maximus64/pigeki/RP2040_minimal.kicad_pcb

## KiCad design RP2040_minimal.kicad_pcb (2023-03-06)

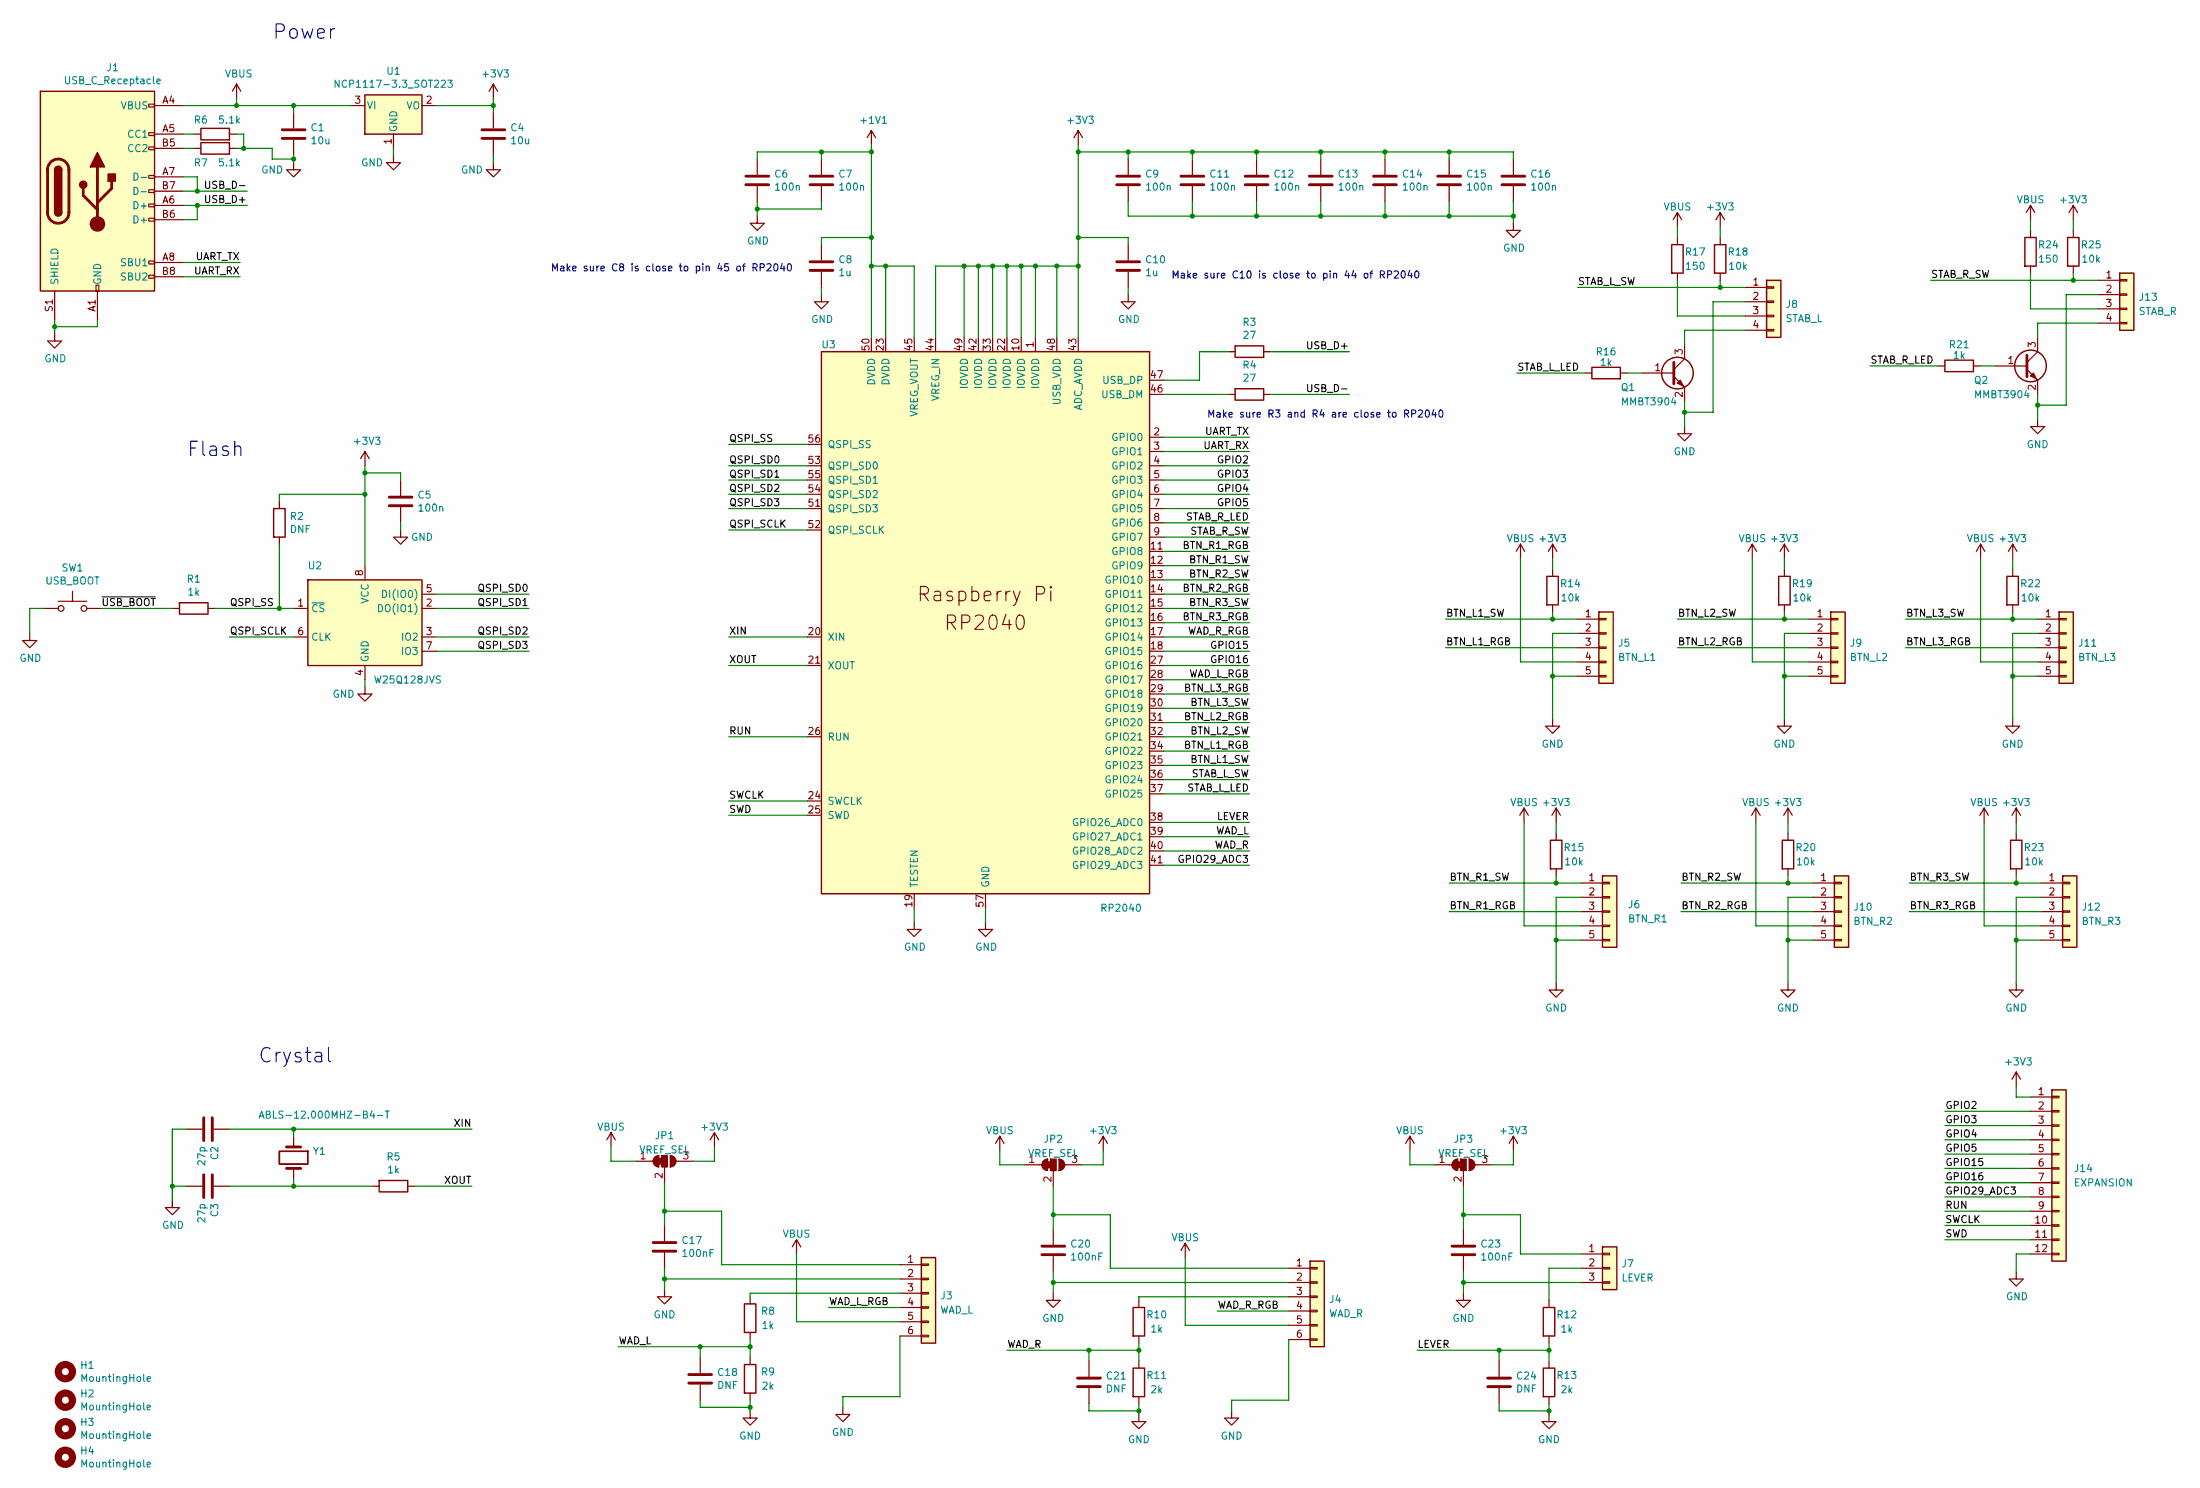
[picture p2: schematic RP2040_minimal.kicad_sch, PIGEKI]

Parts:
C1, C4: 10u; C_0805_2012Metric
C2, C3: 27p; C_0402_1005Metric
C5, C6, C7, C9, C11, C12, C13, C14, C15, C16: 100n; C_0402_1005Metric
C8, C10: 1u; C_0402_1005Metric
C17, C20, C23: 100nF; C_0402_1005Metric
C18, C21, C24: DNF; C_0402_1005Metric
H1, H2, H3, H4: MountingHole; MountingHole_2.7mm_M2.5
J1: USB_C_Receptacle; USB_C_Receptacle_Palconn_UTC16-G
J3: WAD_L; JST_XH_B6B-XH-A_1x06_P2.50mm_Vertical
J4: WAD_R; JST_XH_B6B-XH-A_1x06_P2.50mm_Vertical
J5: BTN_L1; JST_XH_B5B-XH-A_1x05_P2.50mm_Vertical
J6: BTN_R1; JST_XH_B5B-XH-A_1x05_P2.50mm_Vertical
J7: LEVER; JST_XH_B3B-XH-A_1x03_P2.50mm_Vertical
J8: STAB_L; JST_XH_B4B-XH-A_1x04_P2.50mm_Vertical
J9: BTN_L2; JST_XH_B5B-XH-A_1x05_P2.50mm_Vertical
J10: BTN_R2; JST_XH_B5B-XH-A_1x05_P2.50mm_Vertical
J11: BTN_L3; JST_XH_B5B-XH-A_1x05_P2.50mm_Vertical
J12: BTN_R3; JST_XH_B5B-XH-A_1x05_P2.50mm_Vertical
J13: STAB_R; JST_XH_B4B-XH-A_1x04_P2.50mm_Vertical
J14: EXPANSION; PinHeader_1x12_P2.54mm_Vertical
JP1, JP2, JP3: VREF_SEL; SolderJumper-3_P1.3mm_Bridged12_RoundedPad1.0x1.5mm_NumberL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
Q1, Q2: MMBT3904; SOT-23
R1, R5, R8, R10, R12, R16, R21: 1k; C_0402_1005Metric
R2: DNF; C_0402_1005Metric
R3, R4: 27; C_0402_1005Metric
R6, R7: 5.1k; R_0402_1005Metric
R9, R11, R13: 2k; C_0402_1005Metric
R14, R15, R18, R19, R20, R22, R23, R25: 10k; C_0402_1005Metric
R17, R24: 150; C_0402_1005Metric
SW1: USB_BOOT; SW_Push_1P1T_NO_CK_KMR2
U1: NCP1117-3.3_SOT223; SOT-223-3_TabPin2
U2: W25Q128JVS; SOIC-8_5.23x5.23mm_P1.27mm
U3: RP2040; RP2040-QFN-56
Y1: ABLS-12.000MHZ-B4-T; Crystal_SMD_HC49-US

Connections:
+1V1: C6.1, C7.1, C8.1, U3.23 (DVDD), U3.45 (VREG_VOUT), U3.50 (DVDD)
+3V3: C4.1, C5.1, C9.1, C10.1, C11.1, C12.1, C13.1, C14.1, C15.1, C16.1, J14.1, JP1.3 (B), JP2.3 (B), JP3.3 (B), R2.1, R14.1, R15.1, R18.1, R19.1, R20.1, R22.1, R23.1, R25.1, U1.2 (VO), U2.8 (VCC), U3.1 (IOVDD), U3.10 (IOVDD), U3.22 (IOVDD), U3.33 (IOVDD), U3.42 (IOVDD), U3.43 (ADC_AVDD), U3.44 (VREG_IN), U3.48 (USB_VDD), U3.49 (IOVDD)
/BTN_L1_RGB: J5.3, U3.34 (GPIO22)
/BTN_L1_SW: J5.1, R14.2, U3.35 (GPIO23)
/BTN_L2_RGB: J9.3, U3.31 (GPIO20)
/BTN_L2_SW: J9.1, R19.2, U3.32 (GPIO21)
/BTN_L3_RGB: J11.3, U3.29 (GPIO18)
/BTN_L3_SW: J11.1, R22.2, U3.30 (GPIO19)
/BTN_R1_RGB: J6.3, U3.11 (GPIO8)
/BTN_R1_SW: J6.1, R15.2, U3.12 (GPIO9)
/BTN_R2_RGB: J10.3, U3.14 (GPIO11)
/BTN_R2_SW: J10.1, R20.2, U3.13 (GPIO10)
/BTN_R3_RGB: J12.3, U3.16 (GPIO13)
/BTN_R3_SW: J12.1, R23.2, U3.15 (GPIO12)
/GPIO2: J14.2, U3.4 (GPIO2)
/GPIO3: J14.3, U3.5 (GPIO3)
/GPIO4: J14.4, U3.6 (GPIO4)
/GPIO5: J14.5, U3.7 (GPIO5)
/GPIO15: J14.6, U3.18 (GPIO15)
/GPIO16: J14.7, U3.27 (GPIO16)
/GPIO29_ADC3: J14.8, U3.41 (GPIO29_ADC3)
/LEVER: C24.1, R12.2, R13.1, U3.38 (GPIO26_ADC0)
/QSPI_SCLK: U2.6 (CLK), U3.52 (QSPI_SCLK)
/QSPI_SD0: U2.5 (DI(IO0)), U3.53 (QSPI_SD0)
/QSPI_SD1: U2.2 (DO(IO1)), U3.55 (QSPI_SD1)
/QSPI_SD2: U2.3 (IO2), U3.54 (QSPI_SD2)
/QSPI_SD3: U2.7 (IO3), U3.51 (QSPI_SD3)
/QSPI_SS: R1.1, R2.2, U2.1 (~CS), U3.56 (QSPI_SS)
/RUN: J14.9, U3.26 (RUN)
/STAB_L_LED: R16.1, U3.37 (GPIO25)
/STAB_L_SW: J8.1, R18.2, U3.36 (GPIO24)
/STAB_R_LED: R21.1, U3.8 (GPIO6)
/STAB_R_SW: J13.1, R25.2, U3.9 (GPIO7)
/SWCLK: J14.10, U3.24 (SWCLK)
/SWD: J14.11, U3.25 (SWD)
/UART_RX: J1.B8 (SBU2), U3.3 (GPIO1)
/UART_TX: J1.A8 (SBU1), U3.2 (GPIO0)
/USB_D+: J1.A6 (D+), J1.B6 (D+), R3.1
/USB_D-: J1.A7 (D-), J1.B7 (D-), R4.1
/WAD_L: C18.1, R8.2, R9.1, U3.39 (GPIO27_ADC1)
/WAD_L_RGB: J3.4, U3.28 (GPIO17)
/WAD_R: C21.1, R10.2, R11.1, U3.40 (GPIO28_ADC2)
/WAD_R_RGB: J4.4, U3.17 (GPIO14)
/XIN: C2.1, U3.20 (XIN), Y1.1
/XOUT: R5.1, U3.21 (XOUT)
/~USB_BOOT: R1.2, SW1.2
GND: C1.2, C2.2, C3.2, C4.2, C5.2, C6.2, C7.2, C8.2, C9.2, C10.2, C11.2, C12.2, C13.2, C14.2, C15.2, C16.2, C17.2, C18.2, C20.2, C21.2, C23.2, C24.2, J1.A1 (GND), J1.A12 (GND), J1.B1 (GND), J1.B12 (GND), J1.S1 (SHIELD), J3.2, J3.6, J4.2, J4.6, J5.2, J5.5, J6.2, J6.5, J7.3, J8.2, J9.2, J9.5, J10.2, J10.5, J11.2, J11.5, J12.2, J12.5, J13.2, J14.12, Q1.2 (E), Q2.2 (E), R6.2, R7.2, R9.2, R11.2, R13.2, SW1.1, U1.1 (GND), U2.4 (GND), U3.19 (TESTEN), U3.57 (GND)
unnamed: C3.1, R5.2, Y1.2
unnamed: C17.1, J3.1, JP1.2 (C)
unnamed: C20.1, J4.1, JP2.2 (C)
unnamed: C23.1, J7.1, JP3.2 (C)
unnamed: J1.A5 (CC1), R6.1
unnamed: J1.B5 (CC2), R7.1
unnamed: J3.3, R8.1
unnamed: J4.3, R10.1
unnamed: J7.2, R12.1
unnamed: J8.3, R17.2
unnamed: J8.4, Q1.3 (C)
unnamed: J13.3, R24.2
unnamed: J13.4, Q2.3 (C)
unnamed: Q1.1 (B), R16.2
unnamed: Q2.1 (B), R21.2
unnamed: R3.2, U3.47 (USB_DP)
unnamed: R4.2, U3.46 (USB_DM)
VBUS: C1.1, J1.A4 (VBUS), J1.A9 (VBUS), J1.B4 (VBUS), J1.B9 (VBUS), J3.5, J4.5, J5.4, J6.4, J9.4, J10.4, J11.4, J12.4, JP1.1 (A), JP2.1 (A), JP3.1 (A), R17.1, R24.1, U1.3 (VI)

Notes on the sheet:
Power
Flash
Make sure C10 is close to pin 44 of RP2040
Crystal
Make sure C8 is close to pin 45 of RP2040
Make sure R3 and R4 are close to RP2040

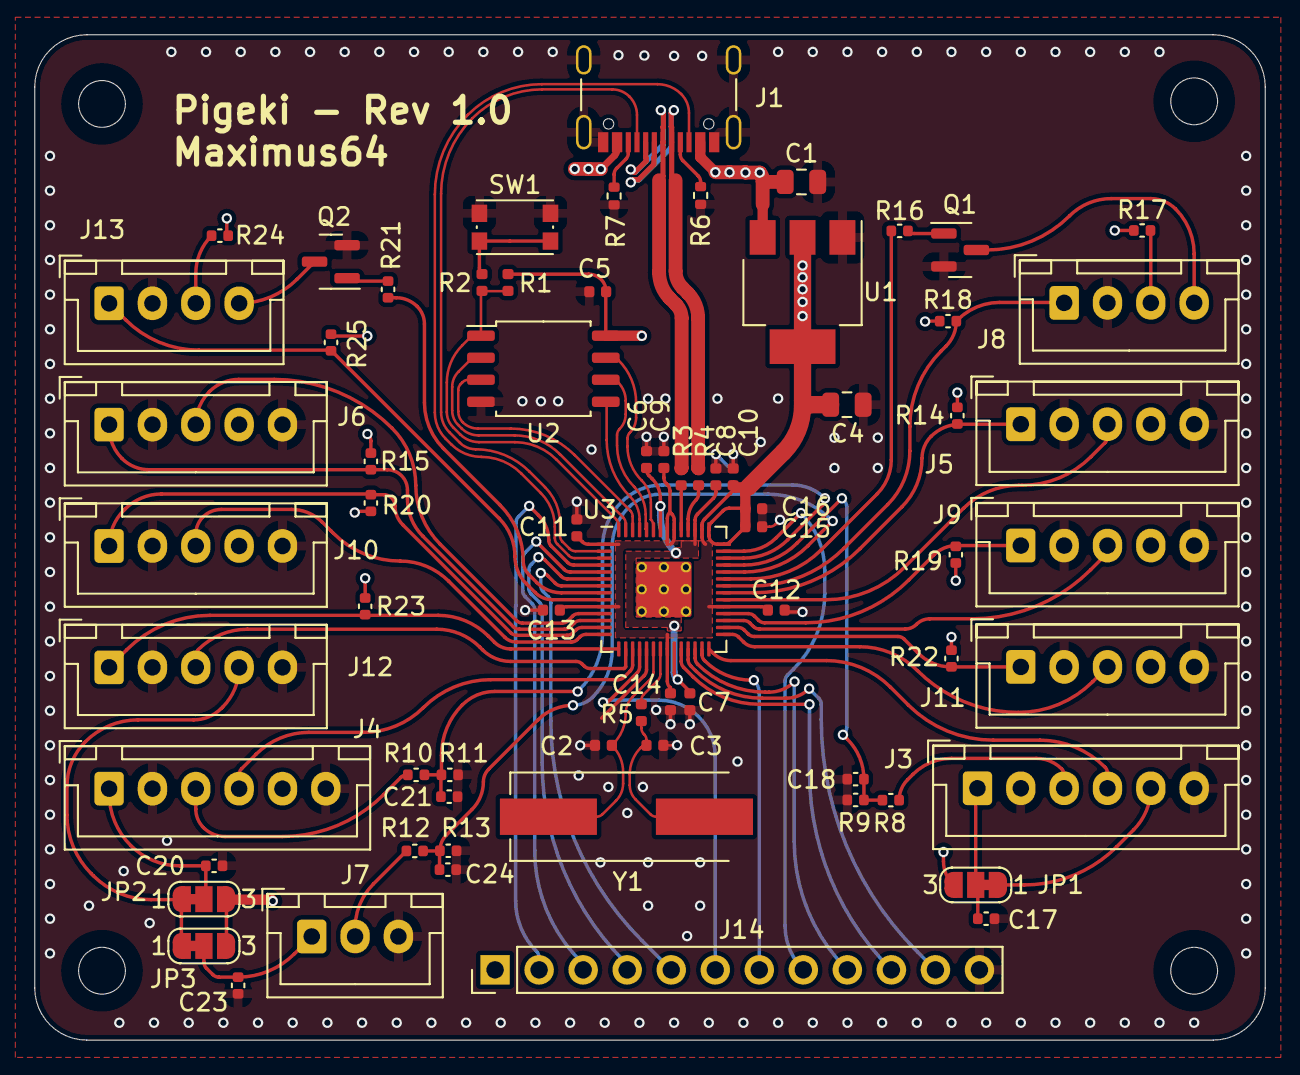
[picture p3: board RP2040_minimal.kicad_pcb from above]

Board: 2 copper layers, 71.0 x 58.0 mm, 74 parts (0 on the bottom side), 65 nets.
