maximus64/pigeki/(commit log)

2023-03-07 add pi pico sdk
2023-03-08 implement asm code to drive multiple WS2812B RGB LED
2023-03-09 add mutex guard when set LED color and drop to USB boot after 7s for now
2023-03-09 remove obsolete schematic
2023-03-10 implement button debouncer
2023-03-10 bring up PWM to drive the stab button LED
2023-03-10 bring up ADC
2023-03-11 change ADC to 8 bits as lower bits are noise anyway
    [main.c]
2023-03-11 lower GPIO drive strength to reduce EMI
    [main.c]
2023-03-11 add scaler + filter for analog input
2023-03-15 seperate out WAD calibration value as they don't match
2023-03-15 limit WAD LED power
2023-03-15 add lever voltage drop correction
    [main.c]
2023-03-15 implement set led HID command, remove debug code
2023-03-15 add start up glow LED animation
